AseptX/VMC/BOM.xlsx

Composant | Nombre | Prix | Lien
Capteur | 1 | 2.19 | https://www.mouser.fr/ProductDetail/Sensirion/SHT40I-HD1B-R2?qs=T%252BzbugeAwjjEpn3Km0P29Q%3D%3D
AOP | 2 | 0.51 | https://www.mouser.fr/ProductDetail/onsemi/LMV321SN3T1G?qs=0n%252BW%2FEG%252BKm7HuocqUdEYQg%3D%3D
MOS | 1 | 1.58 | https://www.mouser.fr/ProductDetail/onsemi-Fairchild/RFD16N06LESM9A?qs=9QHlZzIagUYPo7gAjH1TQg%3D%3D
Potentiomètre | 1 | 0.85 | https://www.mouser.fr/ProductDetail/Bourns/PTV09A-4030U-B502?qs=Qzws7J6gxqz%2FfesVw0UbEg%3D%3D
Ventilateur ? | 1 | 9.43 | https://www.mouser.fr/ProductDetail/Sunon/EF92251B2-1000U-A99?qs=EU6FO9ffTwdqq7n0zeqkew%3D%3D
 |  | Total
 |  | 14.56
