AseptX/VMC/LTspice/VMC/VMC.asc

R1: res; 10k
R2: res; 250k
R3: res; 5000
R4: res; 2700
R5: res; 7700
R6: res; 83.3
U1: SHT40I_HD1B_R2
U2: LM321LV
U3: LM321LV
U4: ADP7105-5.0
U6: SI2306K
V2: voltage; 12
V3: voltage; SINE(0 5 0.05)
Named nets: 0
.include SHT40I_model.sub
.include lm321lv.lib
.include SI2306K.sub
.param RH=55
X1 VRH VDD VSS SHT40I_HD1B_R2
.tran 1s
