AseptX/VMC/LTspice/VMC/ADP7105.asc

C1: cap; 2.2µ; Rser=3m
C2: cap; 2.7n
R1: res; 17.4k
R2: res; 10K
R3: res; 100k
Rload: res; 11
U1: ADP7105
V1: voltage; 4.3
Named nets: 0, IN, OUT
.tran 6m startup
