AseptX/VMC/(commit log)

2025-06-05 Ajout simu spice
    [lm321lv.dsn, lm321lv.opj]
2025-06-06 Fin de la simu ?
    [Calcul resistance.xlsx]
2025-06-06 Ajout BOM provisoire
    [BOM.xlsx, Calcul resistance.xlsx]
2025-06-10 Fin de simu
2025-06-10 Ajout schema + nouvelle ref MOS
    [VMC.kicad_sch]
